poko56/ESP32_Clock_Arch/2_section.png

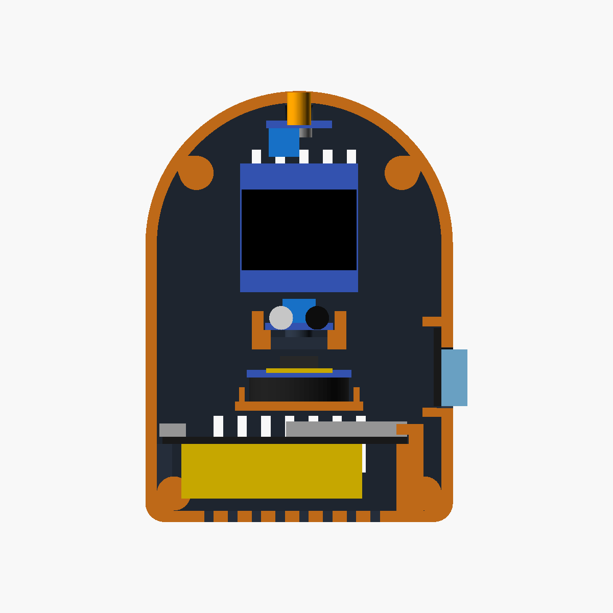
2_section.png
