poko56/ESP32_Clock_Arch/3_back.png

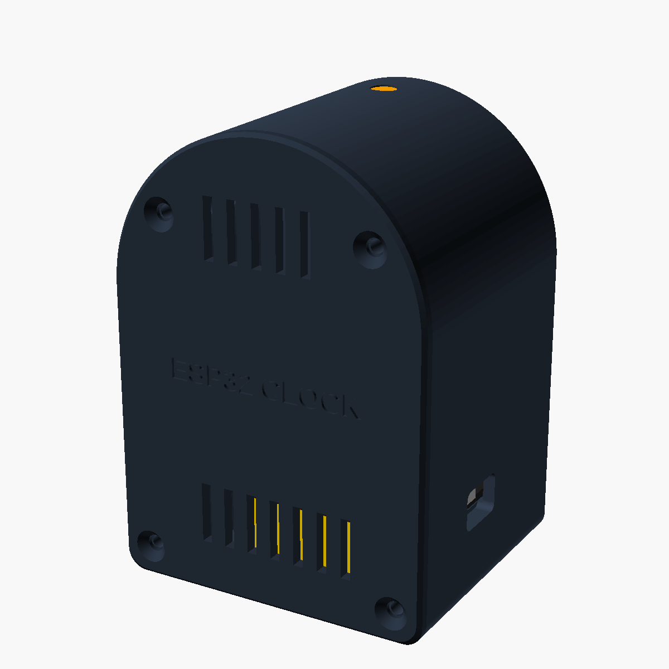
3_back.png
