poko56/ESP32_Clock_Arch/4_inside_mounts.png

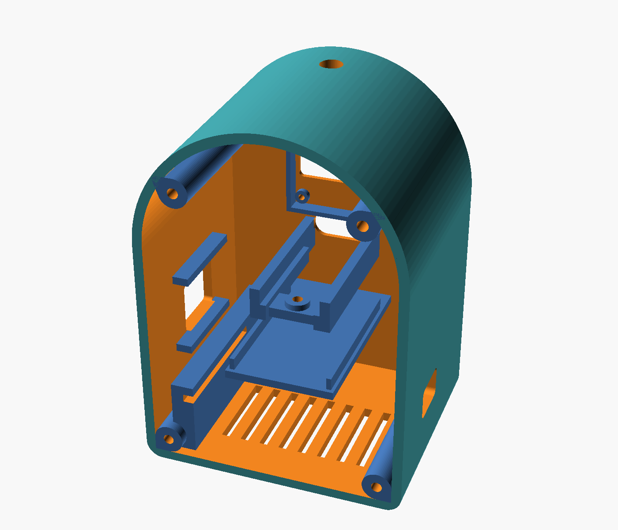
4_inside_mounts.png
