poko56/ESP32_Clock_Arch/5_side_section.png

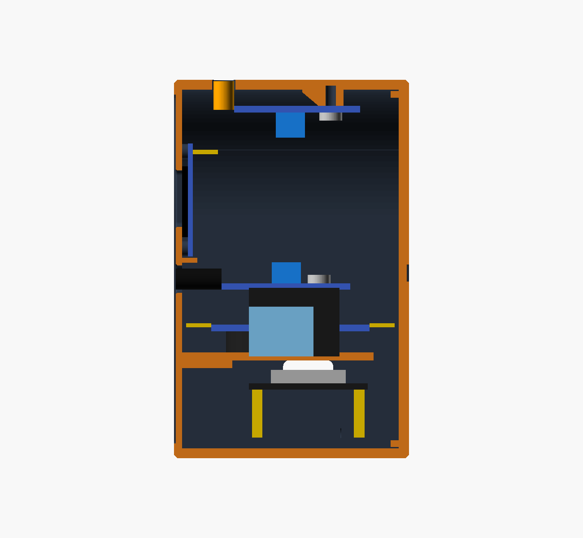
5_side_section.png
