poko56/ESP32_Clock_Arch/arch_cover_print.stl

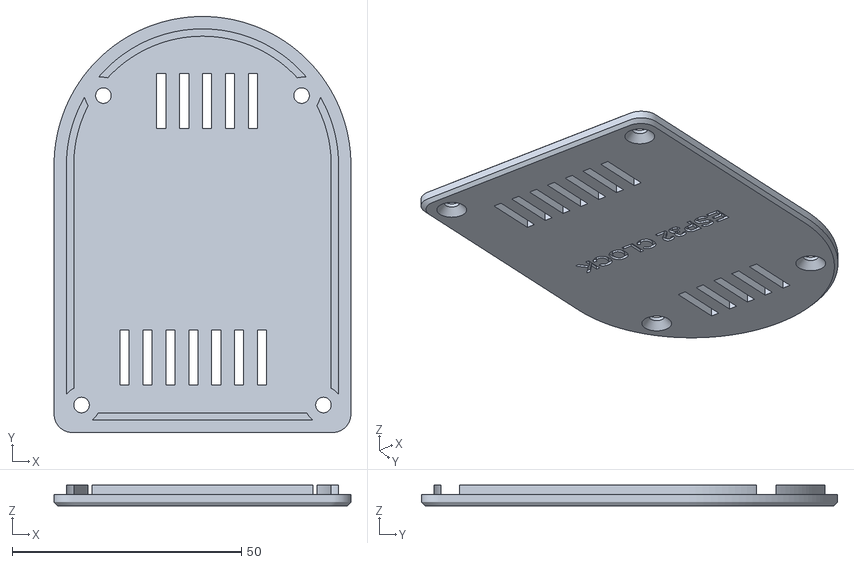
[picture p14: CAD file, 2026-11-09]
arch_cover_print.stl
64.8 x 90.8 x 4.50
