poko56/ESP32_Clock_Arch/arch_body_print.stl

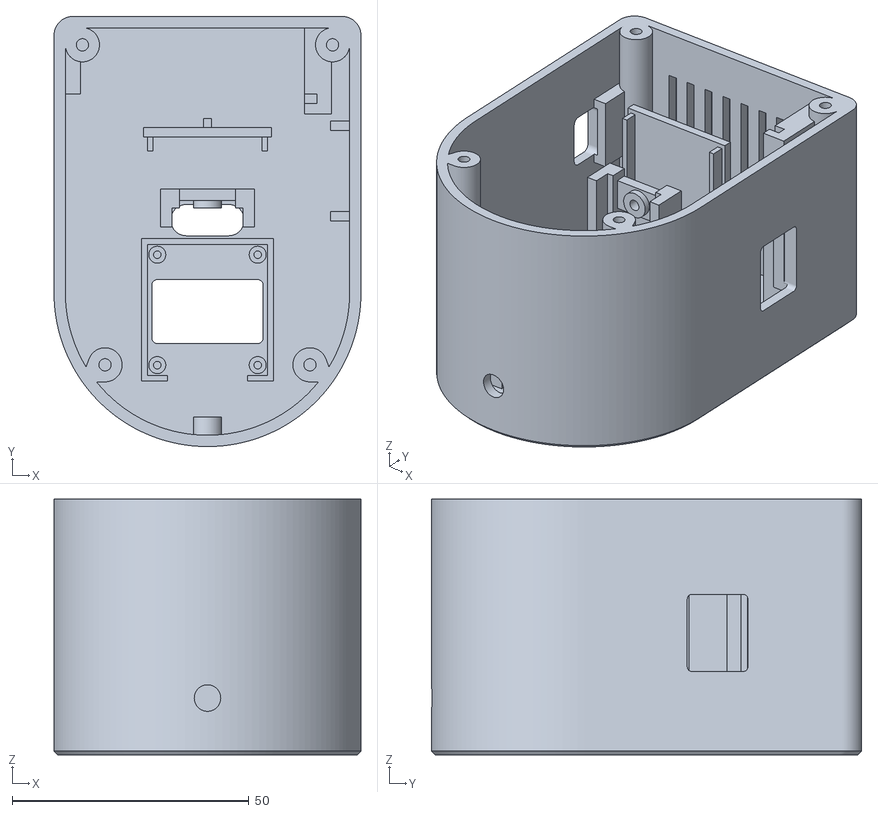
[picture p15: CAD file, 2026-11-09]
arch_body_print.stl
64.8 x 90.8 x 54.0
